norfolkjs/motorized-sumobot/parts_list.md

## Norfolk.js Motorized Sumobot Suggested Parts List

* 1 [Arduino Uno](https://www.amazon.com/gp/product/B0168B39N4/)
* 1 [Arduino Uno Motor Shield](https://www.sainsmart.com/products/l293d-motor-drive-shield-for-arduino)
* 2 [Motors](https://www.sparkfun.com/products/13302)
* 2 [Wheels](https://www.sparkfun.com/products/13259)
* 1 [9-V Battery Clip](http://amzn.com/B00NIOQN9M)
* 1 9-V Battery
* 4 [M-F Lead Wires](http://amzn.com/B00AC4NQYG)
* 1 [16mm Steel Bearing Ball](http://amzn.com/B00FTUIB16)
* 1 [Plastic Kit Case](https://www.dollartree.com/household/storage-organization/Plastic-Storage-Boxes-with-Hinged-Lids-3-qt-/500c541c541p306621/index.pro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)
* 6 #4 x 3/8" screws
* 4 4-40 X 1” screws for motors
* 4 4-40 X ⅜" nuts for motors
* 1 [3-D printed wheel holder](https://github.com/makenai/sumobot-jr/blob/master/3d_print/BallCaster.stl)
* 1 Wood Laser-cut Chassis - You can order a custom cut from www.ponoko.com and upload motorized-sumobot.svg to the service. Choose Birch Plywood 0.125in thickness for material type. 

### Optional Bluetooth Version

* 1 [Lipo Battery](http://www.ebay.com/itm/2x-2S-7-4V-1000mAh-20C-LiPo-RC-Battery-JST-Plug-for-RC-Helicopter-Airplane-Hobby-/252572685263)
* 1 [Lipo Battery charger](https://www.amazon.com/gp/product/B00CR9RJO2)
* 1 [HC-06 Bluetooth Module](https://www.amazon.com/DSD-TECH-Wireless-Bluetooth-Transceiver/dp/B01FCQZ8VW)
* 1 [PS3 controller](https://www.amazon.com/XFUNY-Controller-PlayStation-Black-White-Camouflage/dp/B00RMZUHNQ)
