norfolkjs/motorized-sumobot/materials/BallCaster.stl

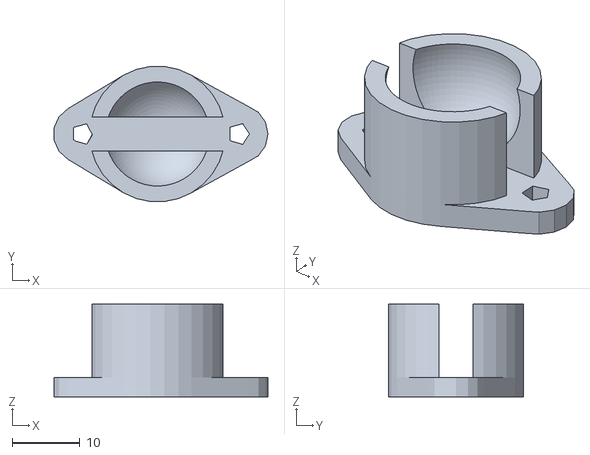
[picture p1: CAD file, 2019-07-12]
materials/BallCaster.stl
31.6 x 19.9 x 13.7
