norfolkjs/motorized-sumobot/materials/battery_case.stl

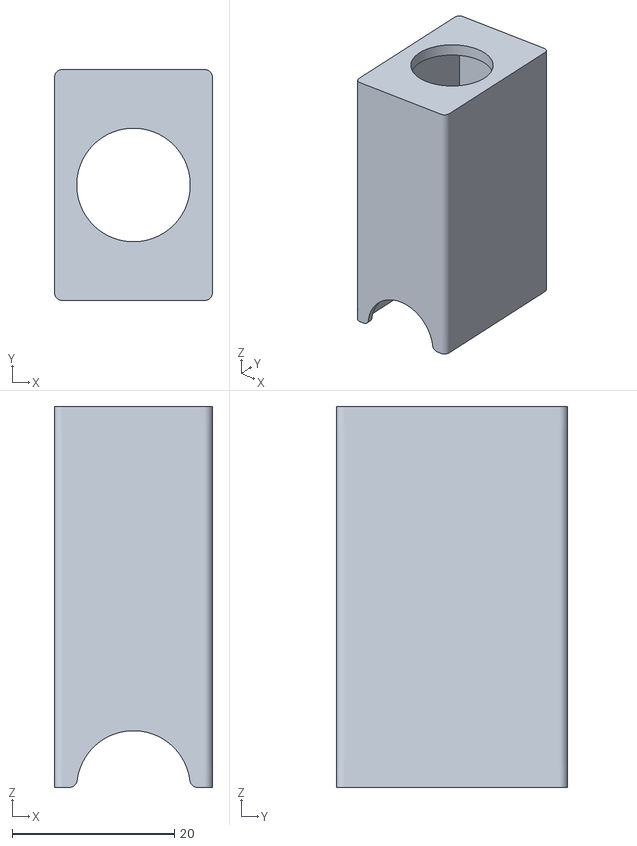
[picture p2: CAD file, 2016-07-13]
materials/battery_case.stl
19.5 x 28.5 x 47.0
