norfolkjs/motorized-sumobot/(list of files, cad)

Other CAD files:
materials/motorized-sumobot-3mm.dwg
