norfolkjs/motorized-sumobot/assembly-instructions.pdf

# MOTORIZED

# SUMOBOT

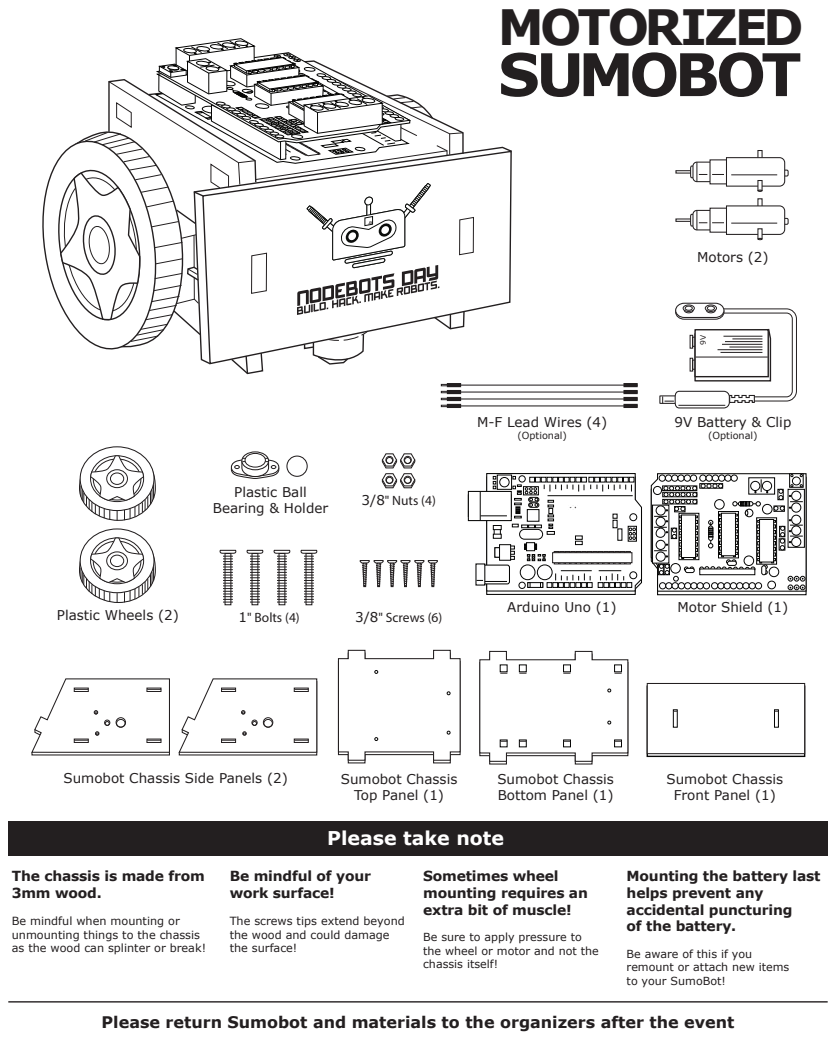
[picture p3: page 1]
Plastic Wheels (2); Sumobot Chassis Side Panels (2); Sumobot Chassis; Sumobot Chassis Bottom Panel (1); Sumobot Chassis Front Panel (1); Plastic Ball Bearing & Holder; 1" Bolts (4); 3/8" Screws (6); 3/8" Nuts (4); Motor Shield (1); 9V Battery & Clip (Optional); Motors (2); M-F Lead Wires (4) (Optional); Arduino Uno (1)

Top Panel (1)
Please take note

The chassis is made from
3mm wood.

Be mindful of your
work surface!

Sometimes wheel
mounting requires an
extra bit of muscle!

Mounting the battery last
helps prevent any
accidental puncturing
of the battery.

Be mindful when mounting or
unmounting things to the chassis
as the wood can splinter or break!

The screws tips extend beyond
the wood and could damage
the surface!

Be sure to apply pressure to
the wheel or motor and not the
chassis itself!

Be aware of this if you
remount or attach new items
to your SumoBot!

Please return Sumobot and materials to the organizers after the event

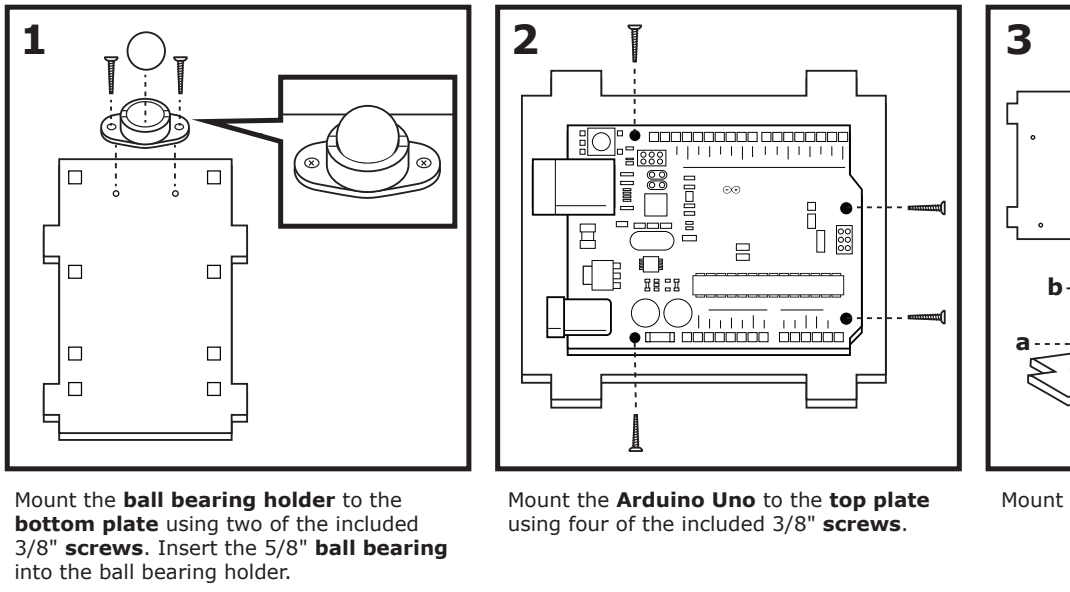
[picture p4: figure]
Mount the ball bearing holder to the bottom plate using two of the included; into the ball bearing holder.; Mount the Arduino Uno to the top plate using four of the included 3/8" screws.
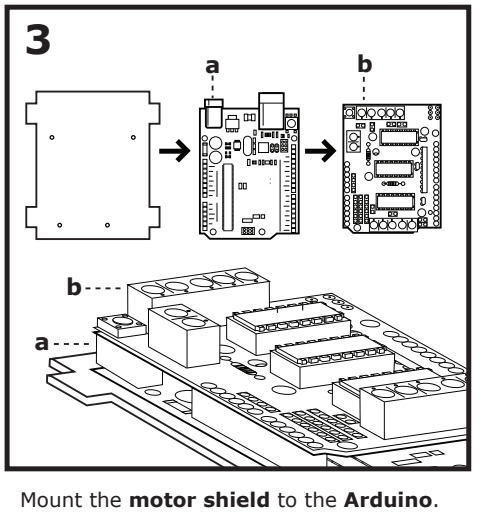
[picture p5: figure]
Mount the motor shield to the Arduino.
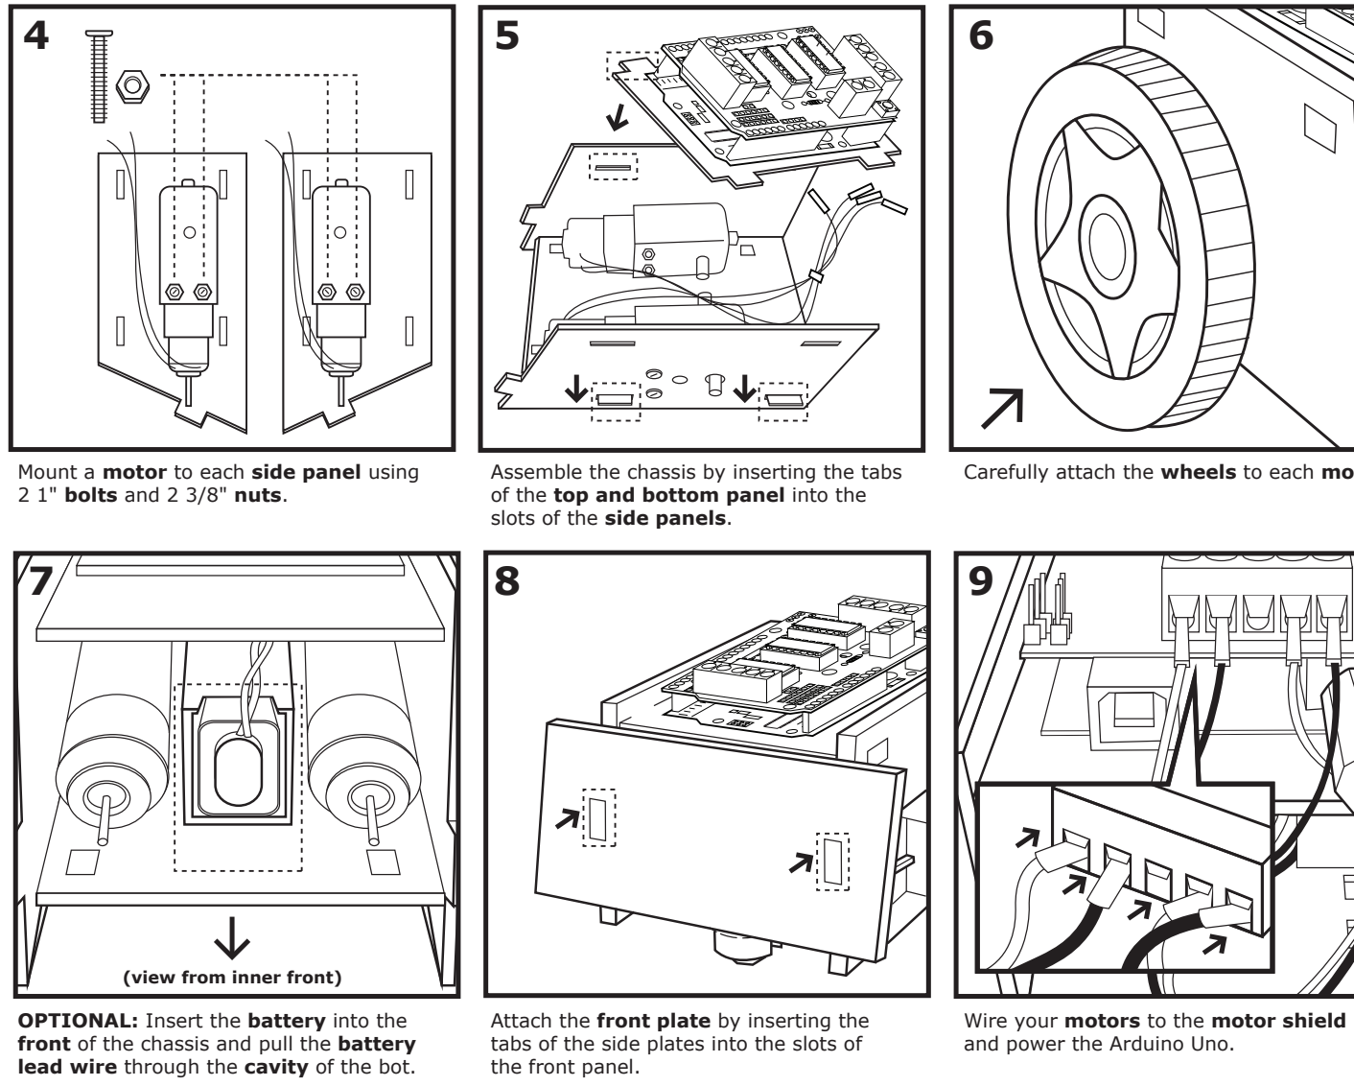
[picture p6: figure]
Mount a motor to each side panel using 2 1" bolts and 2 3/8" nuts.; of the top and bottom panel into the slots of the side panels.; OPTIONAL: Insert the battery into the; Attach the front plate by inserting the; the front panel.; Wire your motors to the motor shield and power the Arduino Uno.; (view from inner front)

Visit github.com/norfolkjs/motorized-sumobot for more code information.

## Looking for the original sumobot-jr? Go to sumobotkit.com

3/8" screws. Insert the 5/8" ball bearing

Assemble the chassis by inserting the tabs

Carefully attach the wheels to each motor.

front of the chassis and pull the battery lead wire through the cavity of the bot. We will supply your battery during your robot battle.

tabs of the side plates into the slots of
