norfolkjs/motorized-sumobot/wiring_diagram.pdf

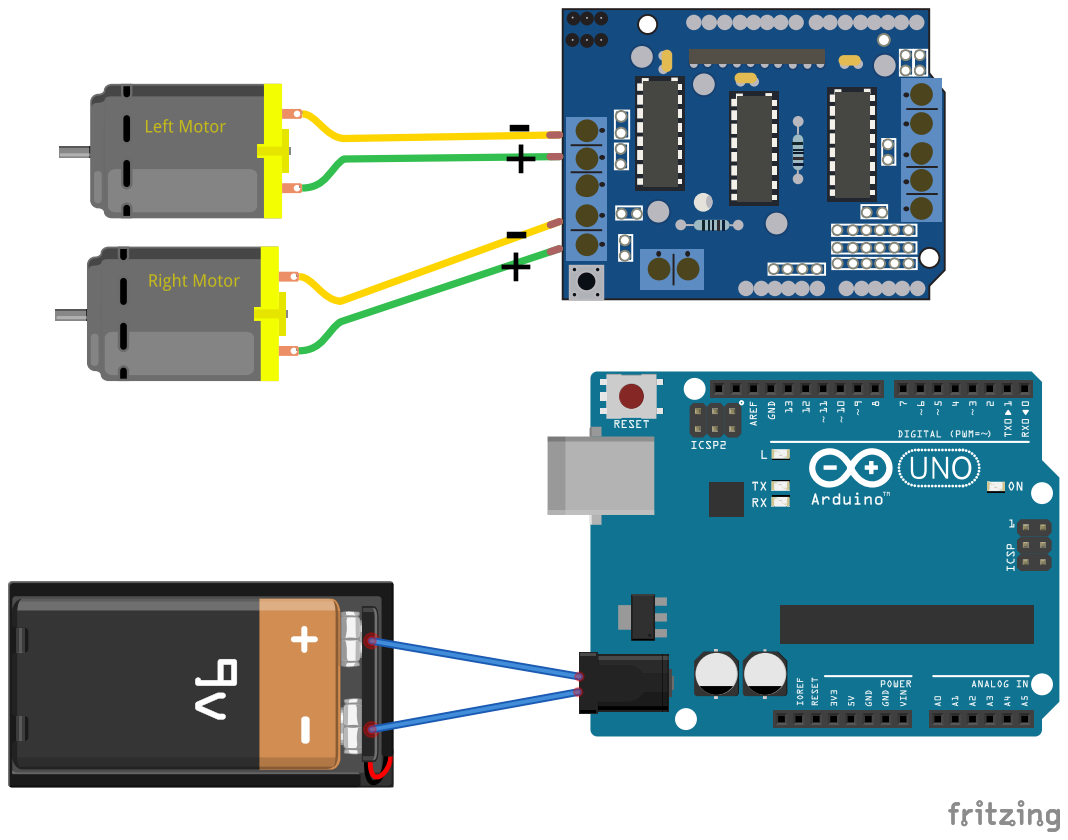
[picture p7: page 1]
