norfolkjs/motorized-sumobot/(commit log)

2016-07-11 Add Brandon's wiring diagram
2016-07-11 Add CAD files from 757 Makerspace
    [BallCaster.stl, Sumobot-jr-3mm-motorized.dwg]
2016-07-11 Add motorized-sumobot code
2016-07-12 Update to diagram
    Now shows positive and negative wires for motors.
2016-07-12 Updated diagram
    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
2016-07-13 Add case for 9V battery
    [battery_case.stl]
2016-07-14 Labeled wires and verified diagram
2016-07-14 Removed servo2
2016-07-15 Update assembly instructions
2016-07-22 Add Cutting Plans from 757 Makerspace
    [motorized-sumobot-3mm.dwg]
2016-07-28 Add @paulchinjr assembly video
2017-07-20 replace BallCaster.stl with copy from upstream.
    [BallCaster.stl]
2019-07-12 Update BallCaster for 2019 dimensions - wider screw holes, scaled about 96%, and light cleanup around one of the holes
    [BallCaster.stl]
